JonasMerrell/croxy/out/render-beamjoint-x.png

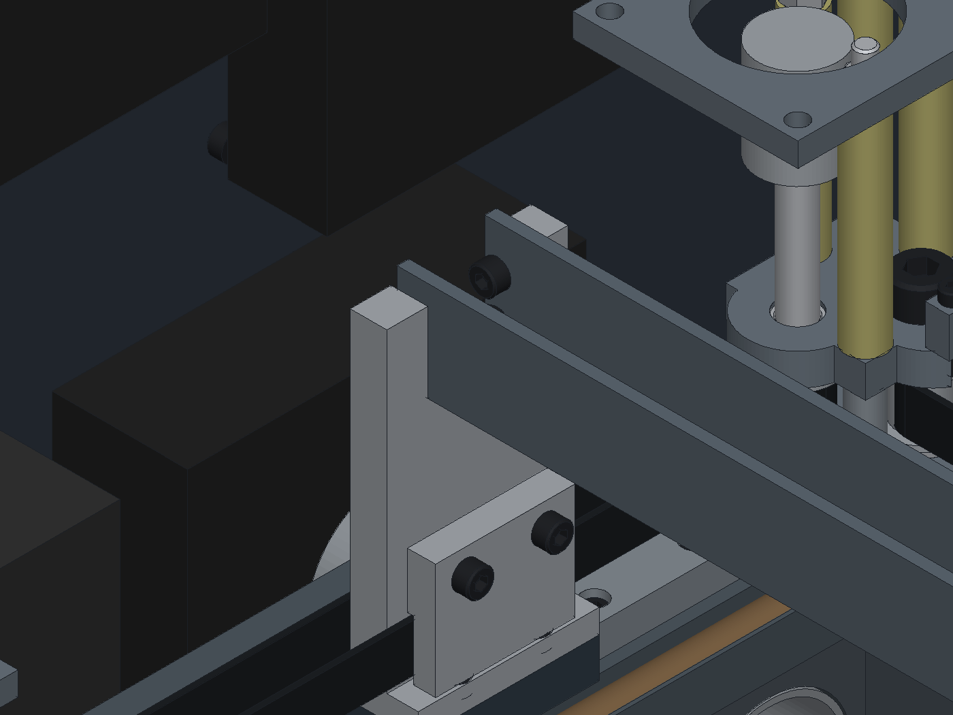
out/render-beamjoint-x.png
