JonasMerrell/croxy/out/render-beamjoint-y.png

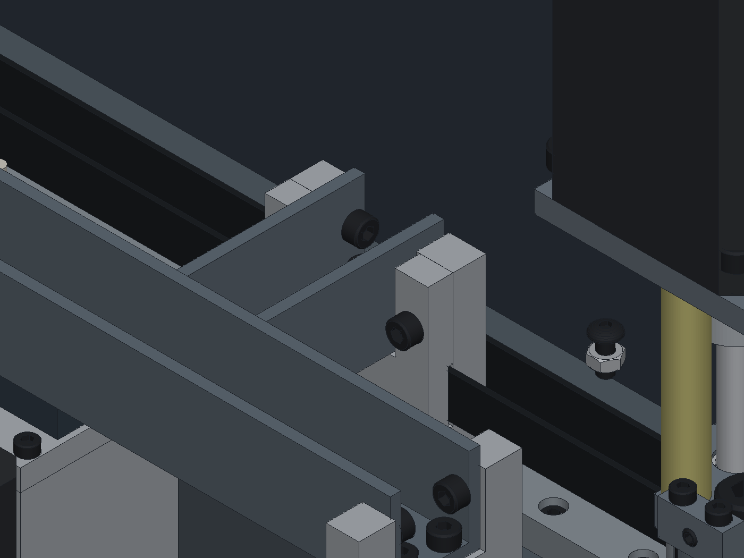
out/render-beamjoint-y.png
