JonasMerrell/croxy/out/render-bedarm.png

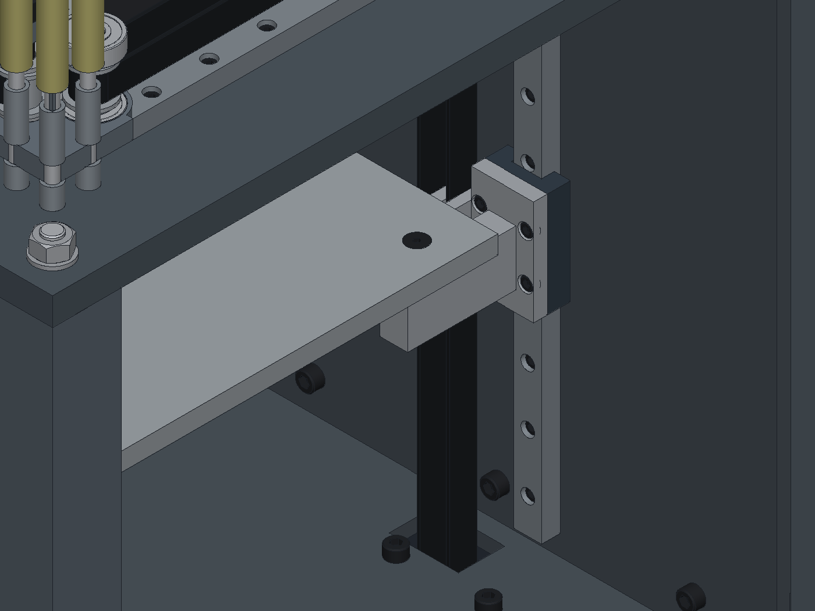
out/render-bedarm.png
