JonasMerrell/croxy/out/render-below.png

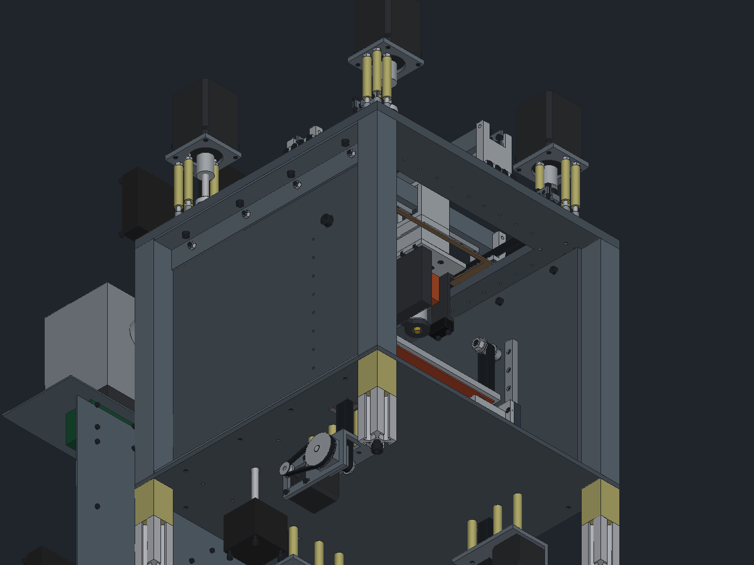
out/render-below.png
