JonasMerrell/croxy/out/render-corner.png

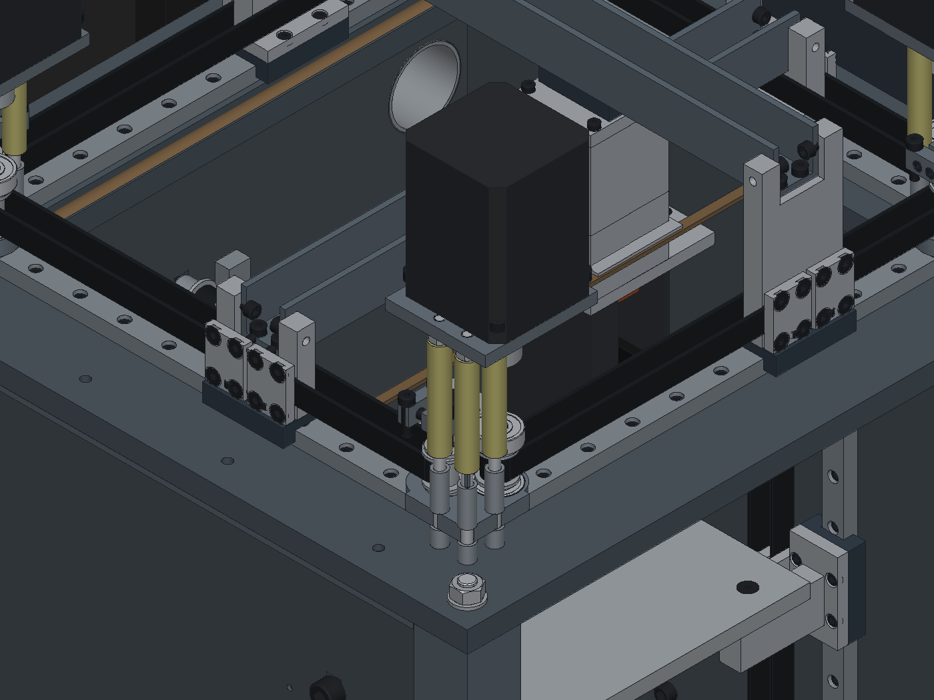
out/render-corner.png
