JonasMerrell/croxy/out/render-front.png

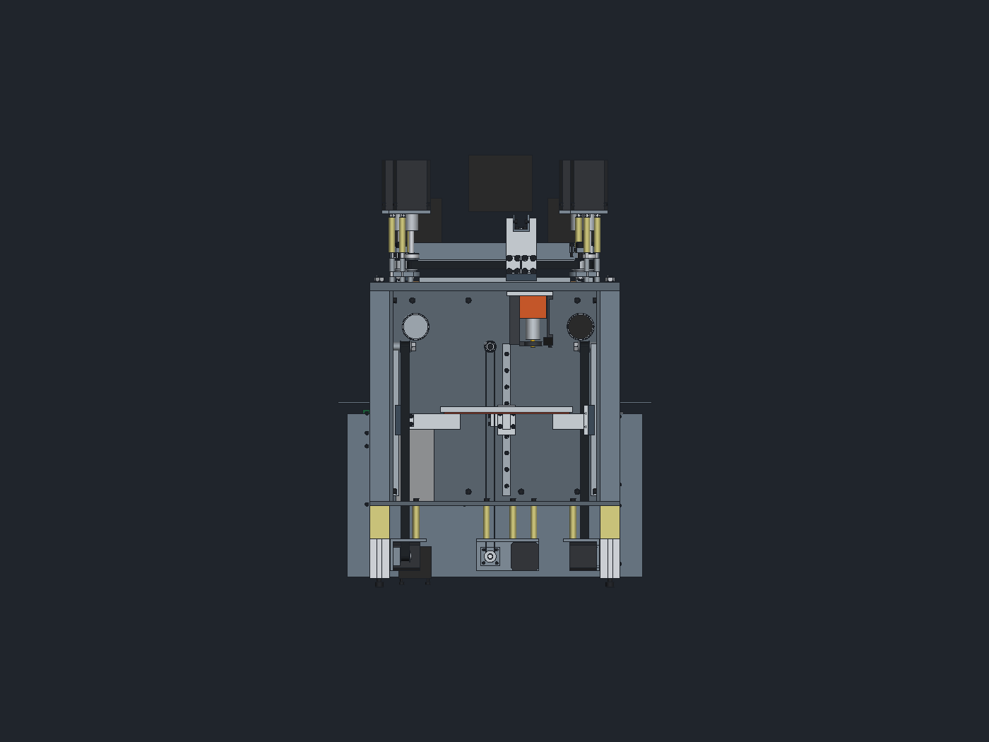
out/render-front.png
