JonasMerrell/croxy/out/render-gantry.png

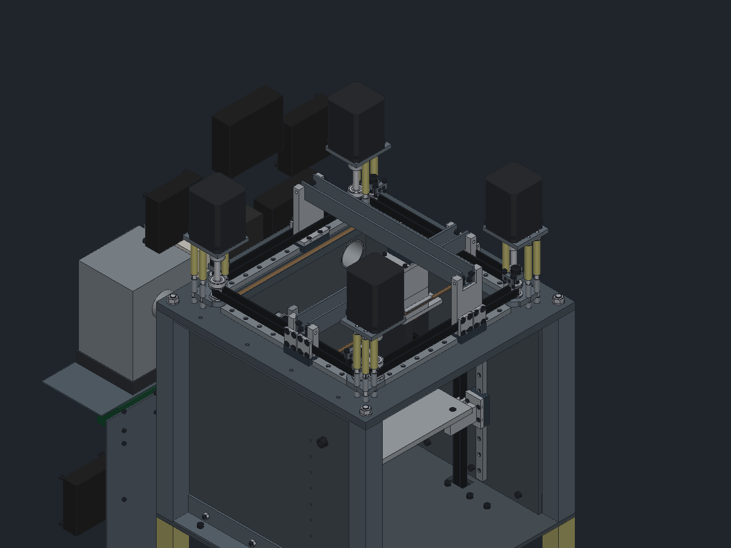
out/render-gantry.png
