JonasMerrell/croxy/out/render-right.png

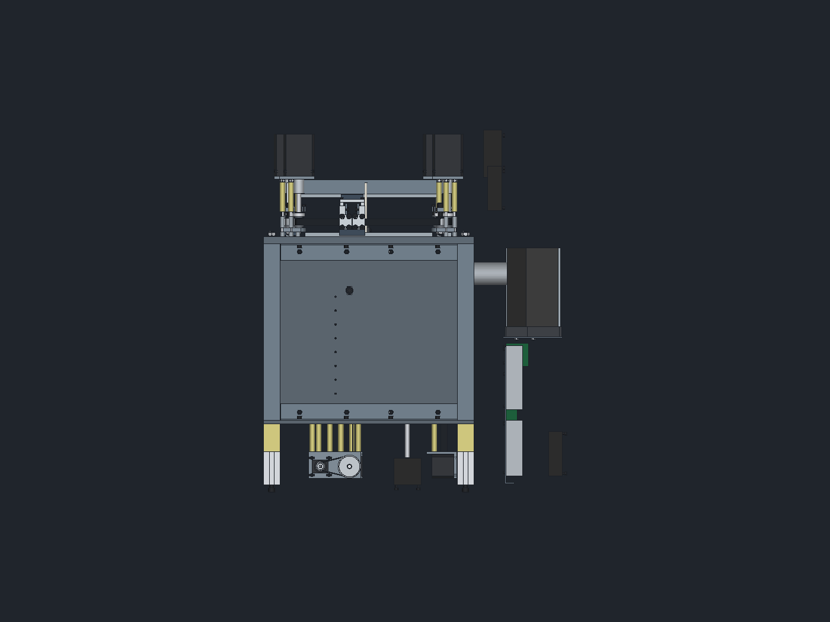
out/render-right.png
