JonasMerrell/croxy/out/render-tensioner.png

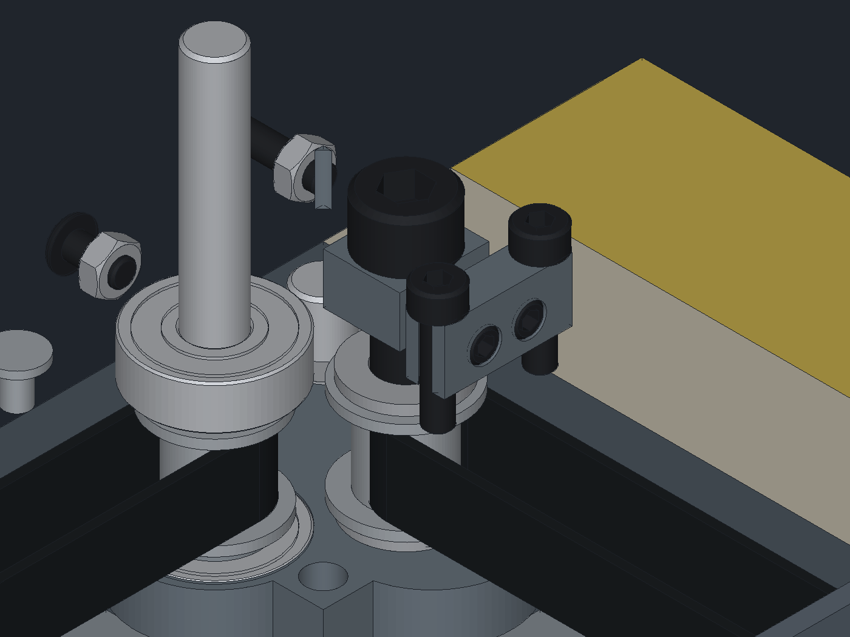
out/render-tensioner.png
