JonasMerrell/croxy/out/render-top.png

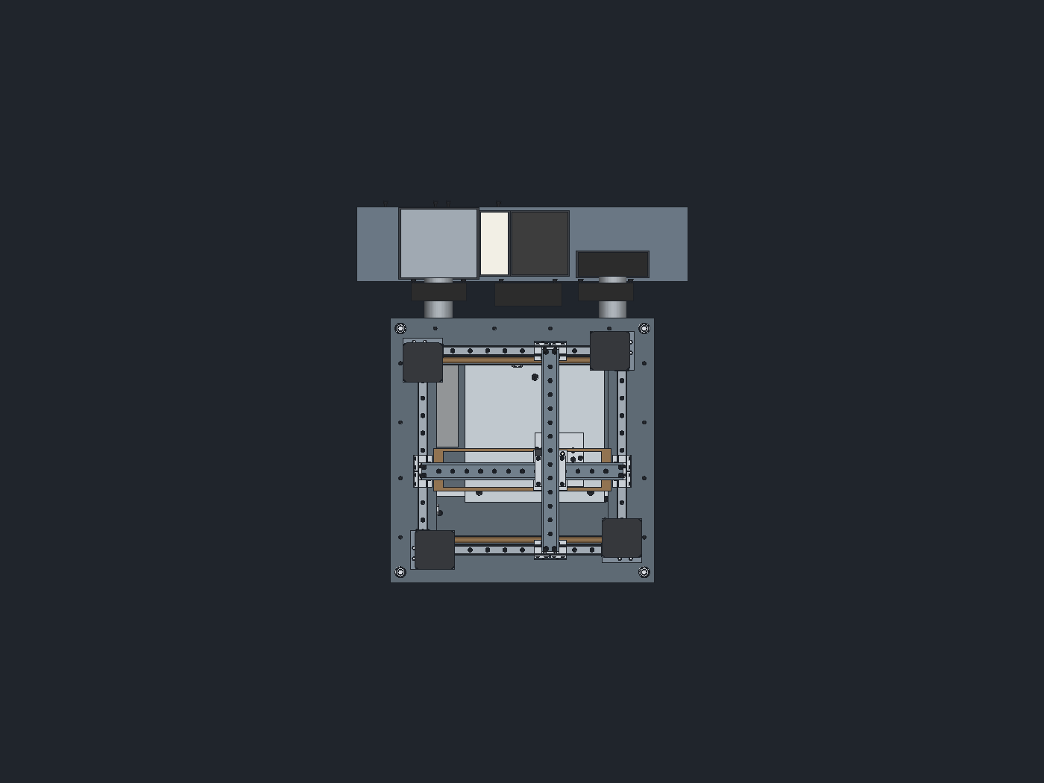
out/render-top.png
