JonasMerrell/croxy/out/render-xend-block.png

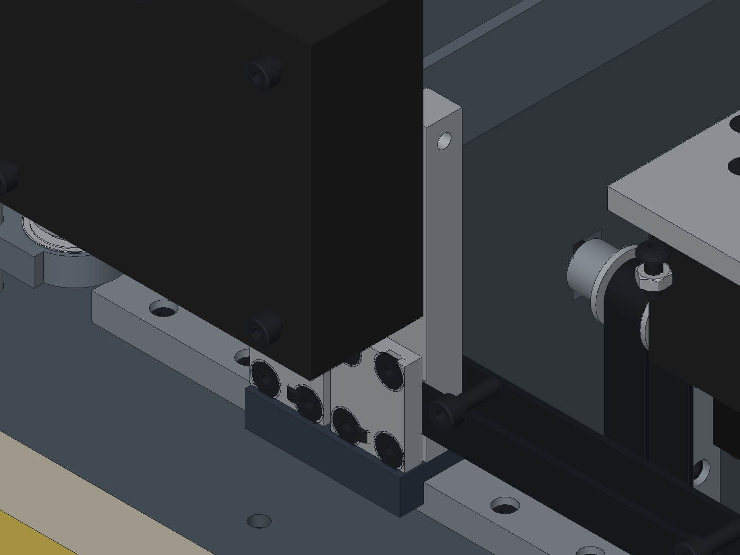
out/render-xend-block.png
