JonasMerrell/croxy/out/render-yend-block.png

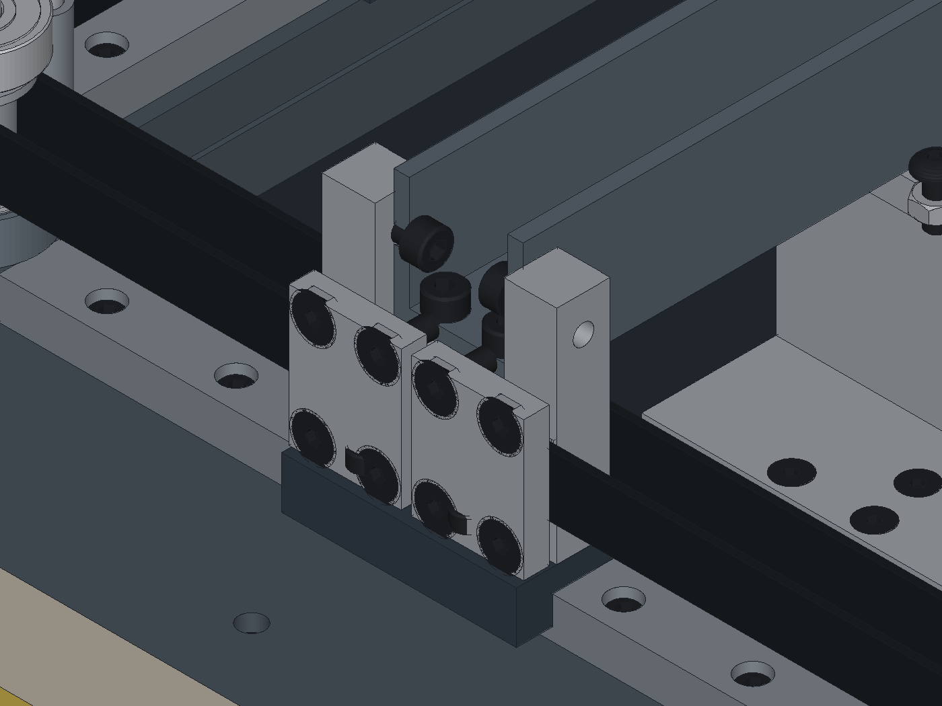
out/render-yend-block.png
