JonasMerrell/croxy/out/render-zdrive.png

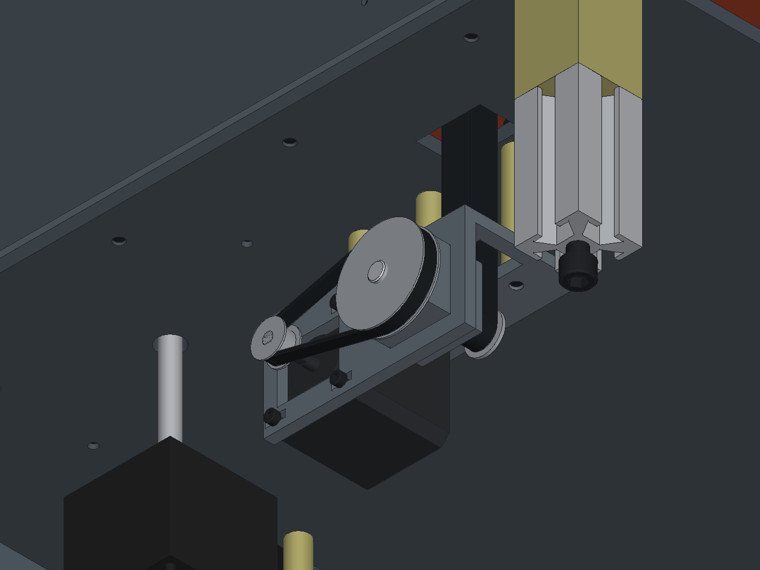
out/render-zdrive.png
