JonasMerrell/croxy/(list of files, cad)

Other CAD files:
out/CroXY.step
