JonasMerrell/croxy/docs/manufacturing.md

# CroXY manufacturing sheet

Generated by `cad/mfg_doc.py` from the rCAD build. Each part lists how it is made, from what, and the setups or print
orientation. Rules: CNC parts are 3-axis mill only (each setup is one face up); printed parts print without supports
(PPS-CF in the hot zone, PET-CF outside); sheet parts come from Send Cut Send with their holes; no welding, no lathe.

## Milled on the 3-axis mill

| Part | Qty | Material | Mass each | How |
|---|---:|---|---:|---|
| Bed arm Z1 | 1 | Aluminium 7075 | 90 g | 7075 block. Top and bottom: 2.5D outline and steps, M4 bed tap; side: carriage holes and cbores; -y side: 2 M3 clamp taps (4 setups, or drill the clamp holes with a jig) |
| Bed arm Z2 | 1 | Aluminium 7075 | 61 g | 7075 block. Top and bottom: 2.5D outline and steps, M4 bed tap; side: carriage holes and cbores; -y side: 2 M3 clamp taps (4 setups, or drill the clamp holes with a jig) |
| Bed arm Z3 | 1 | Aluminium 7075 | 55 g | 7075 block. Top and bottom: 2.5D outline and steps, M4 bed tap; side: carriage holes and cbores; -y side: 2 M3 clamp taps (4 setups, or drill the clamp holes with a jig) |
| Bed, MIC6 200 x 200 x 8 | 1 | Aluminium 6061 | 862 g | bought MIC6 cast plate cut to size; 3 countersunk M4 holes drilled on the mill (1 setup) |
| Belt clamp plate | 8 | Aluminium 7075 | 7 g | 21.7 x 27 x 5 7075 bar, 4 drilled and countersunk holes from the outer face (1 setup). 8 per printer |
| Corner block plate, lower | 4 | Steel | 63 g | 8 mm mild steel plate. 2D contour, Ø10 shaft hole, 8.5 mm idler slot, Ø5.5 rod holes, Ø22 x 7 608 seat from the top face (1 setup) |
| Corner block plate, upper | 4 | Steel | 0 g | 8 mm mild steel plate. 2D contour, Ø10 shaft hole, 8.5 mm idler slot, Ø5.5 rod holes, Ø22 x 7 608 seat from the bottom face, M4 tapped tab holes on the tongue (flip once) |
| Tension slider | 4 | Steel | 7 g | 14 x 12 x 8 steel block, Ø9 drilled from the top (1 setup) |
| Tension tab | 4 | Steel | 5 g | 20 x 6 x 10 steel bar. 2 drilled holes from the top, 2 M5 tapped holes from the side (2 setups) |
| Toolhead neck | 1 | Aluminium 7075 | 79 g | 7075 block 44 x 43 x 33. From the bottom: pocket the air channel leaving a 4 mm top web, tap M3 in the wall ends; from the top: web holes; from +y: air window and M3 (3 setups) |
| Toolhead plate | 1 | Aluminium 7075 | 81 g | 6 mm 7075: contour, air outlet, holes and countersinks from the top; cbores from the bottom (2 setups) |
| X-end block | 2 | Aluminium 7075 | 99 g | One part from 7075 bar 45.4 x 19.2 x 85. Setup 1, bottom face down: profile, step down to the base, carriage cbores, beam screw taps M4. Setup 2, on each side: cheek taps M4 through. Setup 3, outer face up: 2 x 11 GT2 tooth grooves (Ø1 end mill, 0.75 deep) and 8 clamp plate taps M4 (3 setups) |
| Y-end block | 2 | Aluminium 7075 | 44 g | One part from 7075 bar 19.2 x 45.4 x 43. Setup 1, bottom face down: profile, step down to the base, beam seat slot, carriage cbores, beam screw taps M4. Setup 2, on each side: ear taps M4 through. Setup 3, outer face up: 2 x 11 GT2 tooth grooves (Ø1 end mill, 0.75 deep) and 8 clamp plate taps M4 (3 setups) |
| Yoke U | 1 | Aluminium 7075 | 85 g | 7075 block 44 x 43 x 43. U profile contoured standing on end; holes from the bottom and the top (3 setups) |
| Yoke top plate | 1 | Aluminium 7075 | 30 g | 6 mm 7075 plate: contour and holes from the top, cbores from the bottom (2 setups) |
| Z bearing block, inboard | 3 | Steel | 34 g | 10 mm steel plate: contour, Ø22 x 7 seat and holes from one side, M4 tapped (1 setup) |
| Z bearing block, outboard | 3 | Steel | 33 g | 10 mm steel plate: contour, Ø22 x 7 seat and holes from one side (1 setup) |
| Z belt clamp plate | 3 | Aluminium 7075 | 5 g | 5 mm 7075: contour, 2 holes, GT2 tooth grooves on the belt face (1 setup) |

## Send Cut Send: laser cut (and bent)

| Part | Qty | Material | Mass each | How |
|---|---:|---|---:|---|
| Back cover, electronics bay | 1 | Aluminium 6061 | 638 g | 2 mm 5052, SCS cut with fan openings |
| Back cover, filter bay (vented) | 1 | Aluminium 6061 | 884 g | 2 mm 5052, SCS cut with vent slots |
| Back shear plate | 1 | Steel | 4500 g | 6 mm mild steel, SCS laser cut with all holes; hand-tap the M3 rail holes |
| Base plate | 1 | Aluminium 6061 | 4663 g | 6 mm 6061, SCS laser cut with holes; hand-tap the M4 skin holes |
| Beam backer (U channel) | 2 | Steel | 466 g | 3 mm mild steel or 4130, SCS laser cut with holes and bent to a 25 x 25 U. Mill the rail face flat (1 setup, long vise or fixture) |
| Door inner sheet (hot face) | 1 | Stainless steel | 1089 g | 1 mm 304 stainless, SCS laser cut and bent, riveted to the pan walls |
| Door outer pan | 1 | Aluminium 6061 | 1069 g | 2 mm 5052, SCS laser cut and bent into a tray (4 bends, corner reliefs), window cut out |
| Electronics backplate | 1 | Aluminium 6061 | 633 g | 2 mm 5052, SCS cut with all holes and bent |
| Floor plate | 1 | Steel | 6676 g | 6 mm mild steel, SCS laser cut with all holes; hand-tap the M5 angle holes |
| Lid (removable) | 1 | Aluminium 6061 | 1557 g | 2 mm 5052 flat, SCS cut; M4 screws into rivnuts |
| Module divider (filter bay over electronics) | 1 | Aluminium 6061 | 277 g | 2 mm 5052, SCS cut and bent, riveted to the side skins |
| Motor plate | 4 | Steel | 107 g | 6 mm mild steel, SCS laser blank, bore the Ø38.6 pilot and tap M5 on the mill (1 setup) |
| Shutter neck plate (X covers attach here) | 1 | Aluminium 6061 | 4 g | 1.5 mm aluminium, SCS cut; rides on the strip, pushed by the neck, X tapes bonded to it |
| Side shear plate left | 1 | Steel | 4806 g | 6 mm mild steel, SCS laser cut with all holes; hand-tap the M3 rail holes. Idler slot 8.2 x 14 for Z belt tension |
| Side shear plate right | 1 | Steel | 4806 g | 6 mm mild steel, SCS laser cut with all holes; hand-tap the M3 rail holes. Idler slot 8.2 x 14 for Z belt tension |
| Skin back wall (between the chamber and the back module) | 1 | Aluminium 6061 | 1786 g | 2 mm 5052, SCS cut and bent: flanges point back into the module so all fixings sit outside the insulation |
| Skin front strip, Z bay | 1 | Aluminium 6061 | 155 g | 2 mm 5052, SCS cut (and bent), riveted to the side jambs |
| Skin front strip, top bay | 1 | Aluminium 6061 | 549 g | 2 mm 5052, SCS cut (and bent), riveted to the side jambs |
| Skin side left | 1 | Aluminium 6061 | 2274 g | 2 mm 5052-H32, SCS laser cut with all holes, 4 flanges bent in (corner reliefs), powder coat |
| Skin side right | 1 | Aluminium 6061 | 2274 g | 2 mm 5052-H32, SCS laser cut with all holes, 4 flanges bent in (corner reliefs), powder coat |
| Z drive bracket | 3 | Steel | 299 g | 5 mm mild steel, SCS laser cut and bent 90 deg; motor holes slotted for the reduction belt tension; hand-tap the 3 M5 flange holes |

## Waterjet, then milled

| Part | Qty | Material | Mass each | How |
|---|---:|---|---:|---|
| Top plate | 1 | Steel | 7422 g | 12 mm mild steel, waterjet blank (cutout, holes undersize), stress relieve, face both sides, drill/tap M3/M5, mill roller pockets. 1 setup per face |

## 3D printed, no supports

| Part | Qty | Material | Mass each | How |
|---|---:|---|---:|---|
| Beacon bracket | 1 | PPS-CF | 8 g | PPS-CF, printed lying on the web (C profile), no supports; 2 M3 heat-set inserts |
| Cradle for Activated carbon filter | 1 | PET-CF | 58 g | PET-CF, printed as it sits (open tray, no overhangs) |
| Cradle for Air-to-air cooler | 1 | PET-CF | 80 g | PET-CF, printed as it sits (open tray, no overhangs) |
| Cradle for Filter loop blower | 1 | PET-CF | 34 g | PET-CF, printed as it sits (open tray, no overhangs) |
| Cradle for HEPA H13 filter | 1 | PET-CF | 34 g | PET-CF, printed as it sits (open tray, no overhangs) |
| Neck air adapter | 1 | PPS-CF | 4 g | PPS-CF, printed standing on the mounting face; internal channel teardrop-shaped, no supports |
| Part-cooling duct (fed through the hollow neck) | 1 | PPS-CF | 50 g | PPS-CF, printed mount face down; channel roofs are <= 11 mm bridges and the ring channel a 4 mm bridge, no supports; M3 heat-set inserts |
| Shutter strip with X-cover spring reels (moves in Y) | 1 | PPS-CF | 9 g | PPS-CF printed flat (2 mm plate, supportless); the two bought spring-tape reels clip into it |

## Bought, then cut / drilled / faced

| Part | Qty | Material | Mass each | How |
|---|---:|---|---:|---|
| Floor support block (G10, thermal break) | 4 | - |  | G10/FR4 30 mm square bar, cut to 50 mm, faced and drilled Ø9 on the mill (2 setups) |
| Post, steel square tube 30 x 30 x 3 x 320 | 4 | Steel | 814 g | bought mild steel tube, cut and both ends faced square to length on the mill (1 setup per end) |
| Steel angle 30 x 30 x 3 x 319 | 6 | Steel | 424 g | bought mild steel angle, cut to length, 8 holes drilled on the mill with a stop (1 setup per leg) |

## Cut from board

| Part | Qty | Material | Mass each | How |
|---|---:|---|---:|---|
| Door core, PIR board | 1 | - |  |  |
| Door core, hot-face board | 1 | - |  |  |
| Hot-face insulation 20 mm (mineral wool board) | 1 | - |  | rated >= 250 C board, cut with a knife to fit between the frame and the PIR; held captive, no fixings |
| PIR insulation floor 30 mm | 1 | - |  | foil-faced PIR board, cut with a saw; held captive between the hot-face layer and the skin |
| PIR insulation walls 30 mm | 1 | - |  | foil-faced PIR board, cut with a saw; held captive between the hot-face layer and the skin |

## Bought as is

| Part | Qty | Material | Mass each | How |
|---|---:|---|---:|---|
| Activated carbon filter | 1 | - |  |  |
| Air-to-air cooler (finned, ambient side vented) | 1 | - |  |  |
| BTT Kraken (on standoffs) | 1 | - |  |  |
| Beacon3D probe | 1 | - |  |  |
| Blind rivet 4.0 x 8, aluminium, open end | 36 | Aluminium 6061 | 0 g |  |
| Chamber heater: 2 x PTC, 800 W + blower wheel (stand-in) | 1 | - |  |  |
| Chube Conduction hotend | 1 | - |  |  |
| Door glass, inner (borosilicate) | 1 | - |  | cut to size, bonded to the inner sheet with high-temperature RTV silicone |
| Door glass, outer (tempered) | 1 | - |  | cut to size, bonded behind the pan face with RTV silicone |
| Door handle with roller catch | 1 | Stainless steel | 164 g |  |
| Door hinge, lift-off, stainless | 1 | Stainless steel | 79 g |  |
| Electronics fan 80 mm, exhaust | 1 | - |  |  |
| Electronics fan 80 mm, intake | 1 | - |  |  |
| Extruder (Sherpa Heavy style) | 1 | - |  |  |
| Extruder motor (LDO high-temp) | 1 | - |  |  |
| Filter duct, chamber outlet (stainless tube 40 x 1.5) | 1 | Stainless steel | 136 g | bought tube cut to length; slip-fit through the back wall, sealed with high-temp silicone |
| Filter duct, chamber return (stainless tube 40 x 1.5) | 1 | Stainless steel | 139 g | bought tube cut to length; slip-fit through the back wall, sealed with high-temp silicone |
| Filter loop blower (radial 97 mm) | 1 | - |  |  |
| G10 tube 10 x 5.3 x 50 | 9 | - |  | G10/FR4 tube, thermal break |
| G10 tube 10 x 5.3 x 54.3 | 16 | - |  | G10/FR4 tube, thermal break under the motor |
| G10 washer 12 x 4.5 x 2 | 3 | - |  | G10 washer, keeps the arm off the heater layer |
| GT2 20T pulley, 12 mm belt | 7 | Aluminium 6061 | 4 g |  |
| GT2 20T pulley, 6 mm belt, 5 mm bore | 3 | Aluminium 6061 | 3 g |  |
| GT2 20T toothed idler, 12 mm belt | 7 | Steel | 12 g |  |
| GT2 6 mm closed loop 188 mm GT2 6 mm | 3 | - |  |  |
| GT2 60T pulley, 6 mm belt, 8 mm bore | 3 | Aluminium 6061 | 25 g |  |
| Gates EPDM GT2 12 mm Z belt | 3 | - |  |  |
| Gates EPDM GT2 12 mm belt | 4 | - |  |  |
| HEPA H13 filter | 1 | - |  |  |
| Heater blower motor (BLDC, foot-mounted, in the cool bay) | 1 | - |  |  |
| MGN12 rail 230 | 7 | Steel | 162 g |  |
| MGN12H carriage | 7 | Steel | 69 g |  |
| MGN9 rail 250 | 2 | Steel | 102 g |  |
| MGN9H carriage | 2 | Steel | 33 g |  |
| Nozzle | 1 | Brass | 4 g |  |
| PSU 24 V (LRS-350-24 class) | 1 | - |  |  |
| PSU 48 V (LRS-350-48 class) | 1 | - |  |  |
| PTFE filament tube 4 mm | 1 | - |  |  |
| Part-cooling blower (server type, hose to the neck) | 1 | - |  |  |
| Raspberry Pi / host + relays | 1 | - |  |  |
| Rigid shaft coupling D20 L25, 6.35-8 | 4 | Aluminium 6061 | 21 g |  |
| Rubber foot 30 x 15, M6 insert | 4 | - |  |  |
| Shim 8 x 14 x 2 | 8 | Steel | 2 g | DIN 988 shim washer |
| Silicone bed heater | 1 | - |  | custom silicone heater, 3 notches for the arm screws |
| Spacer 12 x 8.2 x 10 | 3 | Steel | 5 g | steel round spacer |
| Spacer 8 x 5.3 x 20 | 16 | Steel | 4 g | steel round spacer |
| Spacer 8 x 5.3 x 9 | 16 | Steel | 2 g | steel round spacer |
| Top bay fan 80 mm, exhaust | 1 | - |  |  |
| Top bay fan 80 mm, intake | 1 | - |  |  |
| Y-cover spring reel, stainless tape (in a plate pocket) | 2 | - |  |  |

## Fasteners and standard parts

| Part | Qty | Used for |
|---|---:|---|
| Bearing 608 | 14 | - |
| ISO 10642 M3x10 | 8 | extruder screw x4, Beacon bracket screw x2, duct screw x2 |
| ISO 10642 M4x12 | 32 | belt clamp screw x32 |
| ISO 10642 M4x20 | 3 | bed screw x3 |
| ISO 4026 M5x10 | 8 | tension jack screw x8 |
| ISO 4032 M3 | 26 | nut x26 |
| ISO 4032 M4 | 38 | rivnut x22, cradle nut x8, hinge nut x4, jamb nut x4 |
| ISO 4032 M5 | 40 | nut x40 |
| ISO 4032 M8 | 7 | nut x7 |
| ISO 4035 M8 | 4 | thin nut x4 |
| ISO 4762 M3x10 | 34 | electronics screw x16, Z clamp screw x6, leg screw x4, Y carriage screw x4, plate screw x4 |
| ISO 4762 M3x14 | 2 | adapter screw x2 |
| ISO 4762 M3x16 | 2 | Beacon screw x2 |
| ISO 4762 M3x6 | 4 | X carriage screw x4 |
| ISO 4762 M3x8 | 133 | MGN12 rail screw x63, MGN9 rail screw x26, carriage screw x16, NEMA17 screw x12, Z carriage screw x12, neck screw x4 |
| ISO 4762 M4x10 | 8 | cradle screw x8 |
| ISO 4762 M4x12 | 36 | fan screw x16, beam screw x8, heater screw x4, heater motor screw x4, blower screw x4 |
| ISO 4762 M4x16 | 8 | tab screw x8 |
| ISO 4762 M4x20 | 12 | bearing block screw x12 |
| ISO 4762 M4x8 | 8 | beam cross screw x8 |
| ISO 4762 M5x12 | 30 | NEMA23 motor screw x16, angle screw x12, handle screw x2 |
| ISO 4762 M5x16 | 24 | shear plate screw x24 |
| ISO 4762 M5x60 | 9 | bracket screw x9 |
| ISO 4762 M5x8 | 12 | angle screw x12 |
| ISO 4762 M6x16 | 4 | foot screw x4 |
| ISO 4762 M8x16 | 4 | leg screw x4 |
| ISO 4762 M8x40 | 3 | Z idler axle x3 |
| ISO 4762 M8x50 | 4 | idler axle x4 |
| ISO 7089 M8 | 15 | washer x15 |
| ISO 7380 M4x10 | 24 | lid screw x14, cover screw x8, base screw x2 |
| ISO 7380 M4x16 | 4 | jamb screw x4 |
| ISO 7380 M4x8 | 17 | base screw x13, hinge screw x4 |
| Shaft Ø5x120 | 16 | M5 threaded rod x16 |
| Shaft Ø8x417.9 | 4 | M8 tie rod x4 |
| Shaft Ø8x54 | 3 | - |
| Shaft Ø8x74 | 4 | - |
| Shaft Ø8x88 | 1 | - |

605 standard parts in all. Shafts named `Shaft Ø5` / `Shaft Ø8` that are used as threaded rod are cut from
M5 / M8 threaded rod. Tapped holes are modelled at the nominal diameter.

## Other bought parts and stand-ins

| Part | Qty |
|---|---:|
| Extrusion 3030x60 | 4 |
| NEMA 17 stepper, 40 mm | 3 |
| NEMA 23 stepper, 76 mm | 4 |
