JonasMerrell/croxy/(commit log)

2026-11-07 First CroXY model: top plate, corner pulley blocks, XY gantry
    Parametric rCAD build (cad/build.py + params.yaml) producing the CroXY
    document, STEP, renders and a clearance sweep over full XY travel.
    Includes the approved layout sketches and spec.
    Claude-Session: https://claude.ai/code/session_01M2WaHCh8LJ6qmXQcQM1feLs
    [CroXY-xy.step]
2026-11-07 Move the XY system on top of the plate, toolhead through a cutout
    Rails, belts, pulleys, corner blocks and beams now sit on the plate's top
    face out of the heated chamber. Towers on the MGN12H carriages clamp the
    belts and carry the beams; motors sit on motor towers above the X beam.
    The plate gets a 246 mm toolhead cutout and the chamber shrinks to 290 mm.
    Clearance sweep is clean at all nine travel poses.
    Claude-Session: https://claude.ai/code/session_01M2WaH8hLJ6qmXQcQM1feLs
    [CroXY-xy.step]
2026-11-07 Offset the toolhead into an open quadrant for a straight filament path
    The extruder and hotend sit 18 mm / 25 mm off the beam cross so filament
    drops straight down a PTFE tube past both beams. The toolhead body hangs
    below the plate on a narrow neck, so it can travel past the cutout edge
    without growing the frame; the chamber grows to 320 mm. Sweep is clean
    with the filament tube included.
    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
    [CroXY-xy.step]
2026-11-07 Add frame shear plates, floor plate, belted Z and bed
    Three Z columns (Z1/Z2 on the side shear plates, Z3 on the back plate),
    NEMA17s below the floor, MIC6 bed on three arms. Clearance sweep now also
    covers the bed at the top and bottom of Z travel.
    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
    [CroXY-xy.step, CroXY.step]
2026-11-07 Add a 1:3 belt reduction to each Z drive
    Each NEMA17 now drives a 60T on an 8 mm jackshaft (two 608s in the steel
    mount) through a 188 mm GT2 6 mm loop; the jackshaft carries the 20T Z
    drive pulley. Z drives raised to fit the 60 mm bay. Adds a Z drive close-up render.
    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
    [CroXY.step]
2026-11-08 Model the enclosure, door, shutter, heater, back module and toolhead detail
    Hot-face layer + PIR + skin walls and floor, double-glazed door, cool Z bay
    on G10 thermal breaks, shutter (Y strip + stainless spring-tape covers),
    PTC chamber heater with the blower motor in the bay, filter loop and
    electronics in the back module, and a detailed toolhead. Clearance sweep
    clean at all 19 poses.
    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
    [CroXY.step]
2026-11-08 Fine tuning: heater, insulation, floor plate, towers, 24 V PSU
    From the first-pass checks in docs/analysis.md: 800 W chamber heater
    (heat-up ~50 min instead of ~3 h), 20 mm hot-face layer (PIR face under
    100 C), 6 mm floor plate (less thermal mass), 7075 X/Y-end towers (0.4 kg
    less on X), 350 W 24 V supply, hollow filter ducts.
    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
    [CroXY.step]
2026-11-08 Manufacturable gantry: milled plates on rod stacks, split towers and clamps, yoke, neck, all bolts modelled
    Corner blocks become two milled steel plates on M5 rod stacks with spacers and a G10
    thermal-break tube under the motor plate. X/Y-end towers are 3-axis milled with separate
    strand clamps. Yoke is a U plus a top plate; the neck is pocketed from below and feeds
    part-cooling air through a printed PPS-CF adapter. Rails and carriages have their holes,
    and every screw, nut, washer, rod and spacer is placed from joint lists and moves with
    the gantry. Clearance sweep is clean at 19 poses.
    Claude-Session: https://claude.ai/code/session_0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
2026-11-08 Manufacturable frame, Z drives and bed arms, all bolts modelled
    Steel square-tube posts clamped by M8 tie rods that run on through G10 blocks into the
    bay legs. Shear plates are SCS cut and join the top and floor plates through bought steel
    angles. Each Z drive hangs on a bent 5 mm SCS bracket from three G10 tubes, with milled
    bearing blocks either side of the web and slotted NEMA17 holes for the reduction belt.
    Bed arms are 2.5D milled 7075 with a separate belt clamp plate; the bed is held by
    countersunk M4s over G10 washers. Top Z idlers sit on cantilevered M8s in slotted holes.
    Z belt_x 18, motor_z -403. Clearance sweep clean at 19 poses.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
    [params.yaml]
2026-11-08 Manufacturable enclosure, door and printed parts; generated manufacturing sheet
    Skin is riveted Send Cut Send 5052 panels with every fixing outside the insulation; the
    side panels run past the back module and their front flanges are the door jambs. Door is
    a bent pan, riveted stainless inner sheet, cut boards and bonded glass on two hinges.
    Back module gets a divider, electronics backplate and printed PET-CF filter cradles.
    Part-cooling duct and Beacon bracket redesigned to print without supports. Every sheet
    fastener hole is cut from the joint lists. cad/mfg_doc.py writes docs/manufacturing.md
    (method, material, setups and the full fastener list). Clearance sweep clean at 19 poses.
    Co-Auth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
    [CroXY.step]
2026-11-09 Beam ends: tower cheeks grip both channel flanges
    Each X/Y-end tower now has cheeks outside the U-channel flanges. Four M4 cross screws per
    beam go from inside the channel through the flanges into tapped cheeks, on top of the two
    web screws per end. Adds cad/closeup.py for close-up renders from a saved build.
    Clearance sweep clean at 19 poses.
    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
    [CroXY.step]
2026-11-09 Make each X/Y end block one milled 7075 part
    The separate strand clamps are gone. Each end block now bolts to its
    MGN12H carriage, holds the beam between its cheeks and anchors both belt
    ends: the belt wraps round a milled post and an M4 set screw locks the
    tail. Cheek taps are through so they can be drilled from outside. The
    Y-end block is notched for the MGN9 rail end. Sweep: 0 clashes at 19 poses.
    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
    [CroXY.step]
2026-11-09 High-tension belt anchors and corner tensioners
    End blocks now anchor the outer strand, outboard of the rail, clear of
    the toolhead neck. Each belt end wraps 180 degrees round an R4.75 milled
    post (Ø5 channels, 2.9 x D deep) and is clamped into 6 milled GT2 tooth
    grooves by a 7075 plate with two M4 countersunk screws.
    Corner tensioner: idler travel 6 -> 8 mm; a steel slider on the M8 idler
    axle is pushed by two M5 jack screws in a tab on a tongue of the upper
    corner plate, then the M8 axle clamps slider and plates.
    Sweep: 0 clashes at 19 poses.
    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
    [CroXY.step]
2026-11-09 Straight toothed belt clamps on the end blocks
    Drop the wrap post and deep channels. The outer strand runs along the
    upright's outer face, which carries 11 milled GT2 tooth grooves per belt
    end; a 7075 clamp plate with four M4 countersunk screws (two above, two
    below the belt) presses each end in. Blocks shrink to 19 mm deep.
    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
    [CroXY.step]
